SomeSpaceNerd/M5Swerve/README.md

# M5Swerve
A compact, accessible, and hobbyist-friendly swerve robot built with M5Stack and 3D-printed parts.

A diagonal view of M5Swerve on a carpet while powered.
## Licensing

This repository contains independently licensed components:

| Component | License | License text |
|---|---|---|
| `software/**` | GNU GPL v3.0 only (`GPL-3.0-only`) | [LICENSE](LICENSE) |
| `hardware/**` | CERN Open Hardware Licence v2 – Weakly Reciprocal (`CERN-OHL-W-2.0`) | [hardware/LICENSE](hardware/LICENSE) |

Each license applies only to its respective component. Third-party components remain subject to their own licensing terms.
