SomeSpaceNerd/M5Swerve/(list of files, cad)

Other CAD files:
hardware/M5Swerve Drivebase.f3z
