SomeSpaceNerd/M5Swerve/(commit log)

2026-08-07 Add hardware
    [M5Swerve Drivebase.f3z, M5Swerve_Drivebase_BOM.csv]
2026-08-07 Add Driver Station
2026-08-09 Add robot code and framework
2026-08-09 Tweak hardware
    Improve servo mount and steering mount
    [M5Swerve Drivebase.f3z]
